woreno/mkultra-raspberry-pi-pico/mcu/docs/UI.png

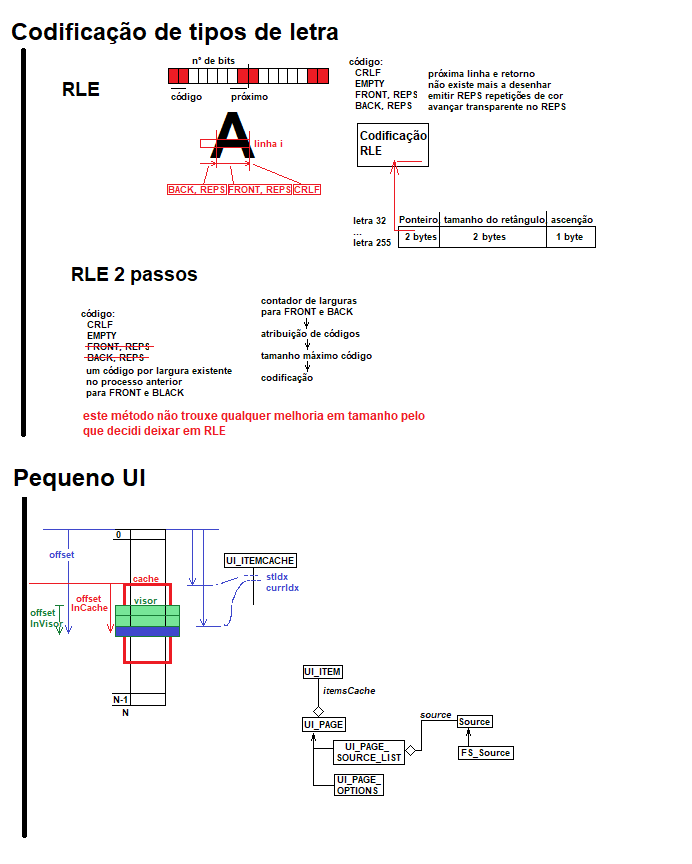
mcu/docs/UI.png
