woreno/mkultra-raspberry-pi-pico/Simple diagram.png

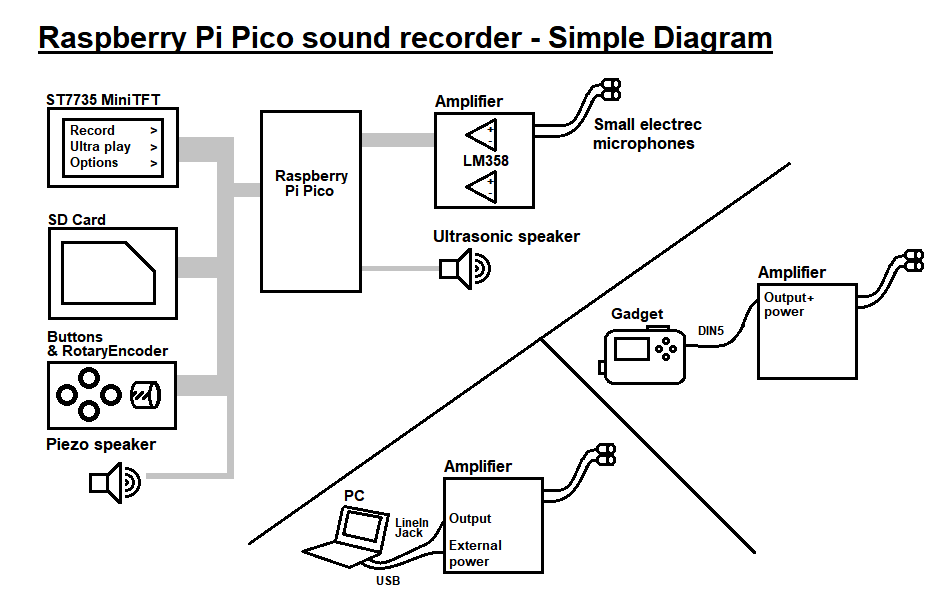
Simple diagram.png
