woreno/mkultra-raspberry-pi-pico/KICAD/microfones.kicad_pcb

## KiCad design KICAD/microfones.kicad_pcb (2026-11-10)

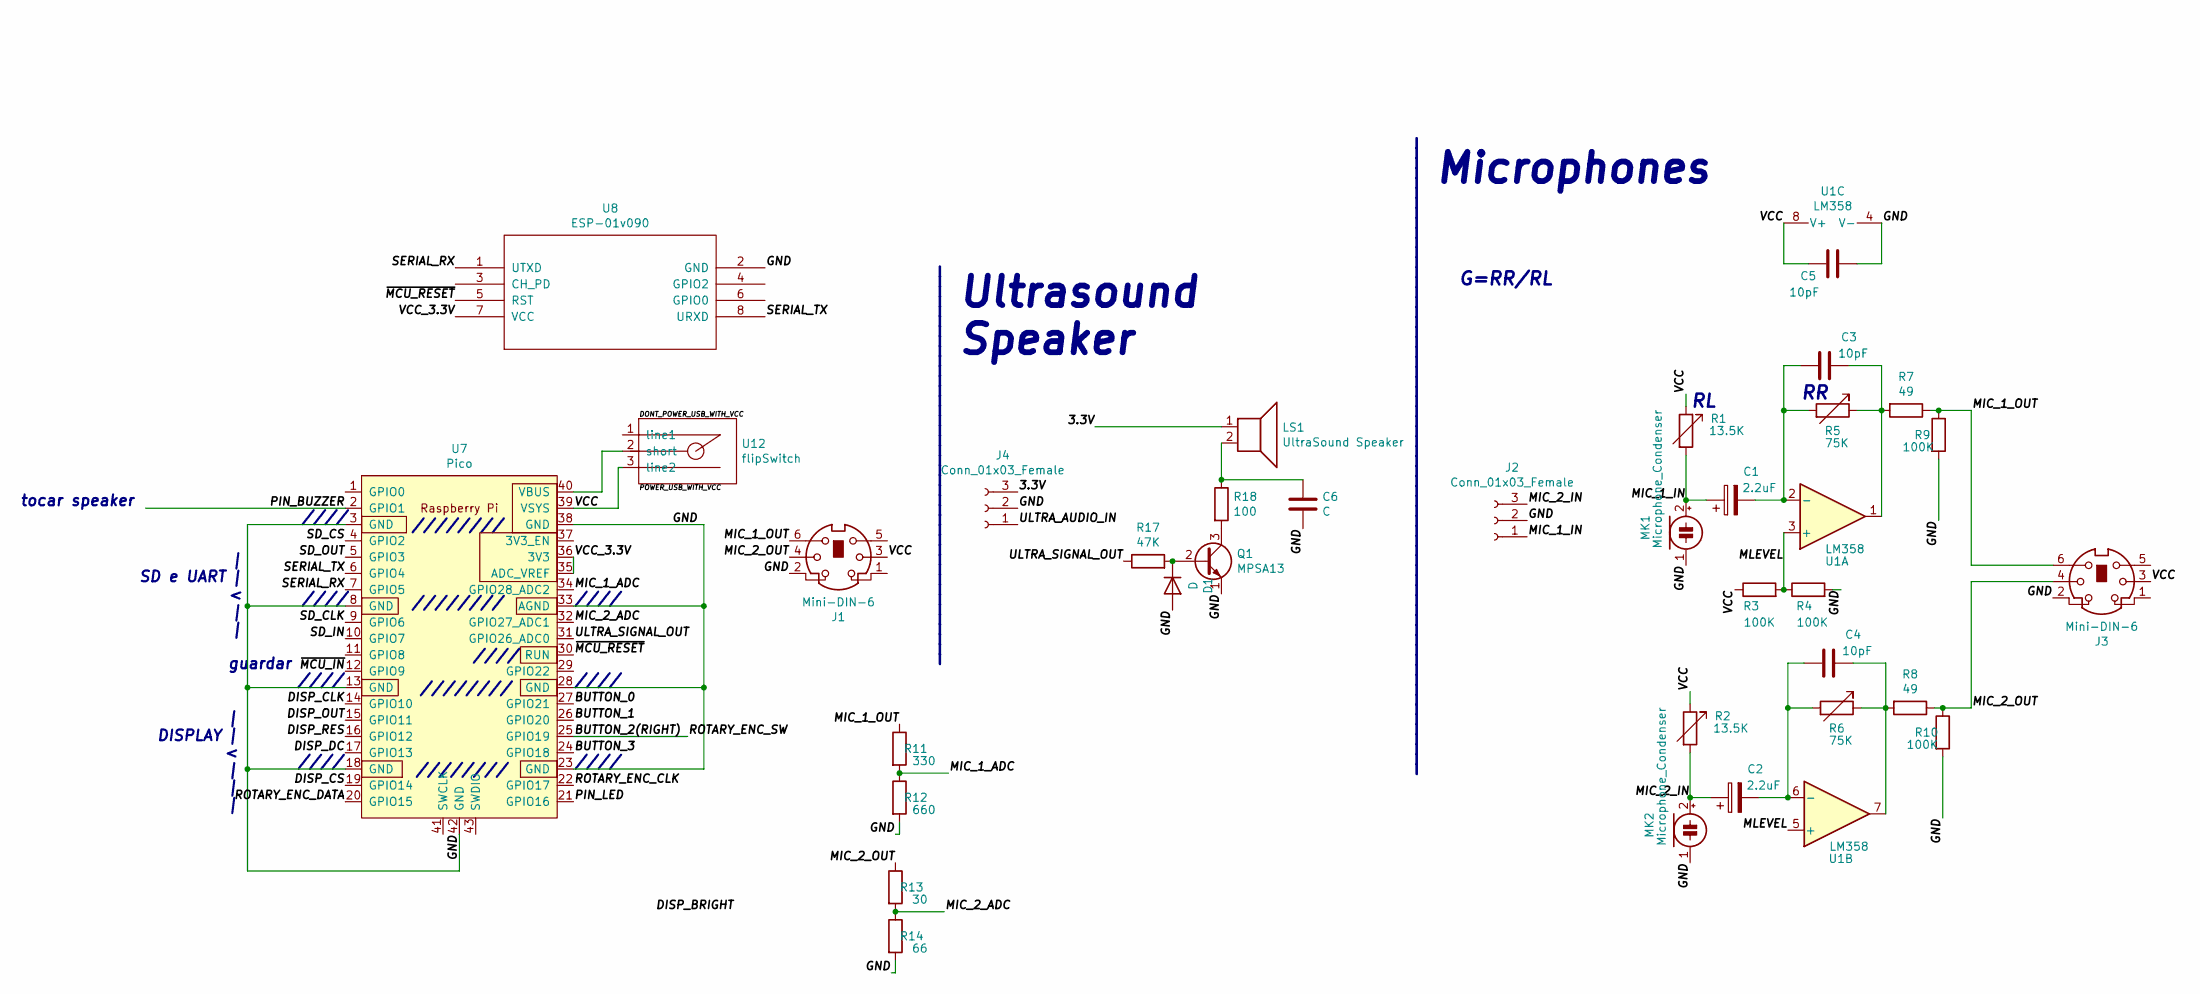
[picture p3: schematic microfones.sch]

Parts:
C1, C2: 2.2uF; standard_2pins
C3, C4, C5: 10pF; standard_2pins_half
C6: C; standard_2pins_half
D1: D; standard_2pins
J1, J3: Mini-DIN-6; minidin5
J2, J4: Conn_01x03_Female; PinHeader_1x03_P1.00mm_Horizontal
LS1: UltraSound Speaker; standard_2pins
MK1, MK2: Microphone_Condenser; standard_2pins
Q1: MPSA13; TO-92_Inline
R1, R2: 13.5K; standard_2pins
R3, R4, R9, R10: 100K; standard_2pins
R5, R6: 75K; standard_2pins
R7, R8: 49; standard_2pins
R11: 330; standard_2pins
R12: 660; standard_2pins
R13: 30; standard_2pins
R14: 66; standard_2pins
R17: 47K; standard_2pins
R18: 100; standard_2pins
U1: LM358; standard_DIP_8pins
U7: Pico; RPi_Pico_SMD_TH
U8: ESP-01v090; IDC-Header_2x04_P2.54mm_Horizontal
U12: flipSwitch; flipSwitch3

Connections:
/3.3V: J4.3, LS1.1
/BUTTON_0: U7.27 (GPIO21)
/BUTTON_1: U7.26 (GPIO20)
/BUTTON_2: U7.25 (GPIO19)
/BUTTON_3: U7.24 (GPIO18)
/DISP_CLK: U7.14 (GPIO10)
/DISP_CS: U7.19 (GPIO14)
/DISP_DC: U7.17 (GPIO13)
/DISP_OUT: U7.15 (GPIO11)
/DISP_RES: U7.16 (GPIO12)
/GND: C5.2, C6.2, D1.2 (A), J1.2, J2.2, J3.2, J4.2, MK1.1 (-), MK2.1 (-), Q1.1 (E), R4.2, R9.2, R10.2, R12.2, R14.2, U1.4 (V-), U7.3 (GND), U7.8 (GND), U7.13 (GND), U7.18 (GND), U7.23 (GND), U7.28 (GND), U7.33 (AGND), U7.38 (GND), U7.42 (GND), U8.2 (GND)
/MIC_1_ADC: R11.2, R12.1, U7.34 (GPIO28_ADC2)
/MIC_1_IN: C1.1, J2.1, MK1.2 (+), R1.2
/MIC_1_OUT: J1.6, J3.6, R7.1, R9.1, R11.1
/MIC_2_ADC: R13.2, R14.1, U7.32 (GPIO27_ADC1)
/MIC_2_IN: C2.1, J2.3, MK2.2 (+), R2.2
/MIC_2_OUT: J1.4, J3.4, R8.1, R10.1, R13.1
/MLEVEL: R3.2, R4.1, U1.3 (+), U1.5 (+)
/PIN_BUZZER: U7.2 (GPIO1)
/PIN_LED: U7.21 (GPIO16)
/SD_CLK: U7.9 (GPIO6)
/SD_CS: U7.4 (GPIO2)
/SD_IN: U7.10 (GPIO7)
/SD_OUT: U7.5 (GPIO3)
/SERIAL_RX: U7.7 (GPIO5), U8.1 (UTXD)
/SERIAL_TX: U7.6 (GPIO4), U8.8 (URXD)
/VCC: C5.1, J1.3, J3.3, R1.1, R2.1, R3.1, U1.8 (V+), U7.39 (VSYS), U12.3 (line2)
/VCC_3.3V: U7.35 (ADC_VREF), U7.36 (3V3), U8.7 (VCC)
/~MCU_IN: U7.12 (GPIO9)
/~MCU_RESET: U7.30 (RUN), U8.5 (RST)
unnamed: C1.2, C3.2, R5.2, U1.2 (-)
unnamed: C2.2, C4.2, R6.2, U1.6 (-)
unnamed: C3.1, R5.1, R7.2, U1.1
unnamed: C4.1, R6.1, R8.2, U1.7
unnamed: C6.1, LS1.2, R18.1
unnamed: D1.1 (K), Q1.2 (B), R17.2
unnamed: Q1.3 (C), R18.2
unnamed: U7.40 (VBUS), U12.2 (short)

Notes on the sheet:
| | < | |
SD e UART
| | < | | |
DISPLAY
////
////////
guardar
tocar speaker
Ultrasound Speaker
________________________________________
________________________________________________________________
Microphones
G=RR/RL

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
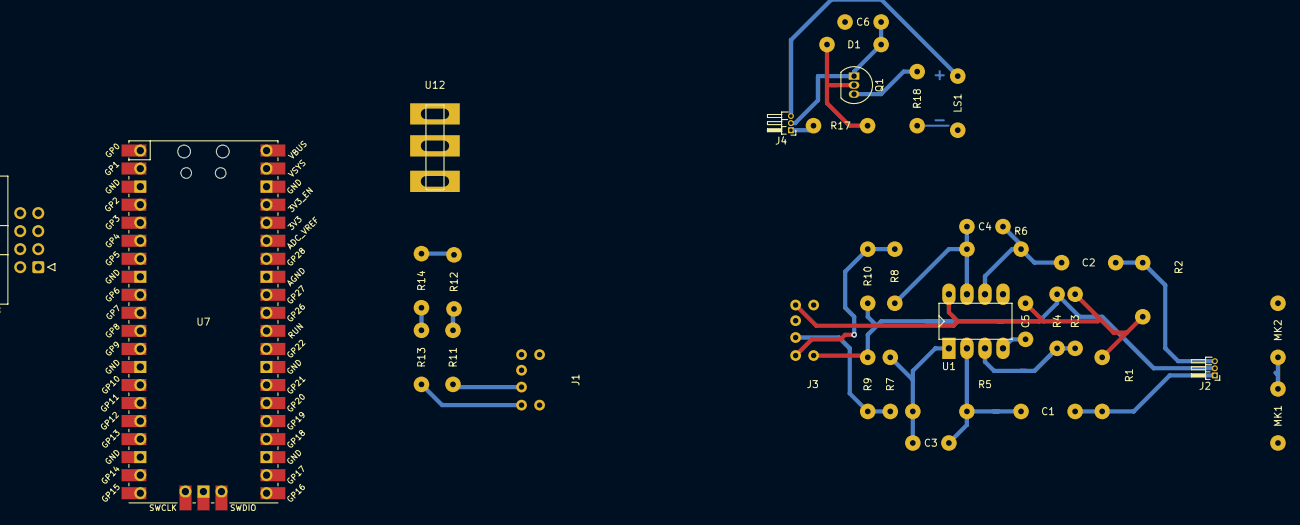
[picture p4: board microfones.kicad_pcb from above]

Board: 2 copper layers, 35 parts (0 on the bottom side), 23 nets.
