woreno/mkultra-raspberry-pi-pico/mcu/charmap.h

 VL_PACK_BEGIN 			   
 struct VL_PACK_MIDDLE FontInfo 			   
 {			   
  W16 ptrOffset;			   
  SW8 ascender;			   
  W8 width;			   
  SW8 height; 			   
 }; VL_PACK_END

 
#define fontEncodeBitmap		1 // pixel a pixel, com resolucao 1 ou 2 bpp
#define fontEncodeRLE			2 // codigos com as larguras e mudanca de linha
#define fontEncodeRLE_2PASS	3 // codigos apenas com para as larguras existentes
#define   fontEncodeSelected	2 // <--- codificacao deste desta fonte
#define fontBlockX				15 // em pixeis
#define fontBlockY				19 // em pixeis
#define fontDefaultSpace       -1 // em pixeis
#define fontMonospaced		    50 // se posto em space_, usa a mesma width
#define fontCodeIsEmpty  0
#define fontCodeIsCRLF   1
#define fontCodeIsFront  2
#define fontCodeIsBack   3
#define fontRLEDataBits  4
#define fontRLECodeBits  2

const W8 fontMap[] VL_STORE_FLASH_GROUP("FONTMAP") VL_ALIGN(4) = {
 0x52,  0x52,  0x52,  0x52,  0x52,  0x52,  0x52,  0x52,  0x52,  0x52,  0xD5,  0xA1,  0x24,  0x05,  0x00,  0x00,  // char ASCII '!' (0x21)
 0x56,  0x56,  0x56,  0x56,  0x56,  0x00,  0x00,  0x00,  // char ASCII '"' (0x22)
 0x93,  0xD6,  0x64,  0x35,  0x59,  0x4D,  0x56,  0x87,  0xD9,  0x61,  0xF6,  0x58,  0x3D,  0x56,  0x8F,  0x95,  0x9A,  0xDA,  0xA2,  0xB5,  0x58,  0x2D,  0x56,  0x8B,  0x15,  0x00,  0x00,  0x00,  // char ASCII '#' (0x23)
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
 0xCC, 0x02, 0x0F,  0x12, 0x13,  
 0xFC, 0x02, 0x0F,  0x0D, 0x13,  
 0x24, 0x03, 0x0F,  0x0D, 0x13,  
 0x44, 0x03, 0x0F,  0x0D, 0x13,  
 0x64, 0x03, 0x0F,  0x0D, 0x13,  
 0x84, 0x03, 0x0F,  0x0C, 0x13,  
 0x94, 0x03, 0x0F,  0x0C, 0x13,  
 0xA4, 0x03, 0x0F,  0x0D, 0x13,  
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
}; // bytes: 672
