woreno/mkultra-raspberry-pi-pico/app_strings.h

const SW8 ui_strs_mkultra[]			VL_STORE_FLASH_GROUP("STRS") = "MKUltra";
const SW8 ui_strs_sep[]				VL_STORE_FLASH_GROUP("STRS") = " - ";
const SW8 ui_strs_init[]			VL_STORE_FLASH_GROUP("STRS") = "Init";
const SW8 ui_strs_esp[]				VL_STORE_FLASH_GROUP("STRS") = "ESP";
const SW8 ui_strs_wifi[]			VL_STORE_FLASH_GROUP("STRS") = "WIFI";
const SW8 ui_strs_server[]			VL_STORE_FLASH_GROUP("STRS") = "Server";
const SW8 ui_strs_sd[]				VL_STORE_FLASH_GROUP("STRS") = "SD Card";
const SW8 ui_strs_formatDisk[]		VL_STORE_FLASH_GROUP("STRS") = "Format Disk";
const SW8 ui_strs_fs[]				VL_STORE_FLASH_GROUP("STRS") = "FS";
const SW8 ui_strs_alloc[]			VL_STORE_FLASH_GROUP("STRS") = "Alloc!";
const SW8 ui_strs_fail[]			VL_STORE_FLASH_GROUP("STRS") = "Failed";
const SW8 ui_strs_invalid[]			VL_STORE_FLASH_GROUP("STRS") = "Invalid";
const SW8 ui_strs_cmd[]				VL_STORE_FLASH_GROUP("STRS") = "cmd";
const SW8 ui_strs_mbr_volumes[]		VL_STORE_FLASH_GROUP("STRS") = "MBR";
const SW8 ui_strs_vol_root[]		VL_STORE_FLASH_GROUP("STRS") = "Root";
const SW8 ui_strs_start[]			VL_STORE_FLASH_GROUP("STRS") = "Start";
const SW8 ui_strs_menu[]			VL_STORE_FLASH_GROUP("STRS") = "Menu";
const SW8 ui_strs_stereo[]			VL_STORE_FLASH_GROUP("STRS") = "Stereo";
const SW8 ui_strs_off[]				VL_STORE_FLASH_GROUP("STRS") = "OFF";
const SW8 ui_strs_on[]				VL_STORE_FLASH_GROUP("STRS") = "ON";
const SW8 ui_strs_writingnotes[]	VL_STORE_FLASH_GROUP("STRS") = "Writing Notes";
const SW8 ui_strs_ready[]			VL_STORE_FLASH_GROUP("STRS") = "Ready";
const SW8 ui_strs_null[]			VL_STORE_FLASH_GROUP("STRS") = "NULL";
const SW8 ui_strs_rate[]			VL_STORE_FLASH_GROUP("STRS") = "Rate";
const SW8 ui_strs_bits[]			VL_STORE_FLASH_GROUP("STRS") = "Bits";
const SW8 ui_strs_done[]			VL_STORE_FLASH_GROUP("STRS") = "Done";
const SW8 ui_strs_stopping[]		VL_STORE_FLASH_GROUP("STRS") = "Stopping...";
const SW8 ui_strs_reconnect[]		VL_STORE_FLASH_GROUP("STRS") = "Reconnect";
const SW8 ui_strs_notconnected[]	VL_STORE_FLASH_GROUP("STRS") = "Not connected";
const SW8 ui_strs_txrecords[]		VL_STORE_FLASH_GROUP("STRS") = "Send Records";
const SW8 ui_strs_notmounted[]		VL_STORE_FLASH_GROUP("STRS") = "Not mounted";
const SW8 ui_strs_sending[]			VL_STORE_FLASH_GROUP("STRS") = "Sending";
const SW8 ui_strs_debugnotes[]		VL_STORE_FLASH_GROUP("STRS") = "Note Debug";
const SW8 ui_strs_wait[]			VL_STORE_FLASH_GROUP("STRS") = "Wait";  
const SW8 ui_strs_hz[]				VL_STORE_FLASH_GROUP("STRS") = "Hz";
const SW8 ui_strs_khz[]				VL_STORE_FLASH_GROUP("STRS") = "KHz";
const SW8 ui_strs_record[]			VL_STORE_FLASH_GROUP("STRS") = "Record";
const SW8 ui_strs_recording[]		VL_STORE_FLASH_GROUP("STRS") = "Recording";
const SW8 ui_strs_recordmics[]		VL_STORE_FLASH_GROUP("STRS") = "Record Mics";
const SW8 ui_strs_testrecord[]		VL_STORE_FLASH_GROUP("STRS") = "Test Record";
const SW8 ui_strs_miclevels[]		VL_STORE_FLASH_GROUP("STRS") = "Mic Levels";
const SW8 ui_strs_playultrawave[]	VL_STORE_FLASH_GROUP("STRS") = "UltraWave";
const SW8 ui_strs_playultrasnd[]	VL_STORE_FLASH_GROUP("STRS") = "Play UltraFile";
const SW8 ui_strs_freq[]			VL_STORE_FLASH_GROUP("STRS") = "Freq";
const SW8 ui_strs_apptitle[]		VL_STORE_FLASH_GROUP("STRS") = "MKUltra";

const W16 sampleRatesArr[]  = { 8000, 11500, 22050, 44100 };
const W16 sampleBitsArr[]   = { 8, 16 };


#define AUDIO_SAMPLE_RATE_8000   0
#define AUDIO_SAMPLE_RATE_11500  1
#define AUDIO_SAMPLE_RATE_22050  2
#define AUDIO_SAMPLE_RATE_44100  3

#define AUDIO_SAMPLE_BITS_8      0
#define AUDIO_SAMPLE_BITS_16     0
