woreno/mkultra-raspberry-pi-pico/uiIconsData.hpp

//Bitmap w:64 h:22 bpp:4 | bytesPerRow:32 (padded) bytesPad:0

#define iconData_W 64
#define iconData_H 22
#define iconData_COLS_BYTESZ 32
#define iconData_REPS  1
#define iconData_ALIGN  4 // bytes
#define iconData_EXTRA_COLS_BYTES  0 // bytes
#define iconData_EXTRA_ROWS  0 // rows
#define iconData_COLS_TOTAL_BYTESZ  32 // bytes
#define iconData_ROWS_TOTAL 22 // bytes
const W8 iconData[] VL_STORE_FLASH_GROUP("ICONDATA") VL_ALIGN(4) =  {
//ROW 0 / 21 

 0xCC, 0xCC, 0xCC, 0xCC, 0xCC, 0xCC, 0xCC, 0xCC, 0xCC, 0xCC, 0xCC, 0x7C, 0x77, 0xC7, 0xCC, 0xCC, 
 0xCC, 0xCC, 0xCC, 0xCC, 0xCC, 0xCC, 0xCC, 0xCC, 0xCC, 0xCC, 0xCC, 0xCC, 0xCC, 0xCC, 0xCC, 0xCC, 
//ROW 1 / 21 

 0xCC, 0xCC, 0xCC, 0xCC, 0xCC, 0xCC, 0xCC, 0xCC, 0xCC, 0xCC, 0x0C, 0xF7, 0xFF, 0x7F, 0xC0, 0xCC, 
 0xCC, 0xCC, 0xCC, 0xCC, 0xCC, 0xCC, 0xCC, 0xCC, 0xCC, 0xCC, 0xCC, 0xCC, 0xCC, 0xCC, 0xCC, 0xCC, 
//ROW 2 / 21 

 0xCC, 0xCC, 0xCC, 0x7C, 0x00, 0x00, 0x70, 0xCC, 0xCC, 0xCC, 0x70, 0xBF, 0xBB, 0xBB, 0x07, 0xCC, 
 0xCC, 0x0C, 0x00, 0x00, 0x00, 0x00, 0x00, 0xC0, 0xCC, 0xCC, 0xCC, 0xCC, 0xCC, 0xCC, 0xCC, 0xCC, 
//ROW 3 / 21 

 0xCC, 0xCC, 0xCC, 0x0C, 0xFF, 0xFF, 0x0F, 0xCC, 0xCC, 0xCC, 0xF0, 0x7B, 0x77, 0xB7, 0x08, 0xCC, 
 0xCC, 0x70, 0xFF, 0xFF, 0xFF, 0xFF, 0xFF, 0x07, 0xCC, 0xCC, 0xCC, 0xCC, 0xCC, 0xCC, 0xCC, 0xCC, 
//ROW 4 / 21 

 0xCC, 0x0C, 0x00, 0xF0, 0xBB, 0xBB, 0x0B, 0xCC, 0xCC, 0xCC, 0xF0, 0x08, 0x00, 0xB7, 0x0B, 0xCC, 
 0x0C, 0xF7, 0xFF, 0xFF, 0xFF, 0xFF, 0xFF, 0x07, 0xCC, 0xCC, 0x00, 0xCC, 0xCC, 0x00, 0xCC, 0xCC, 
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
//ROW 21 / 21 

 0xF0, 0xFF, 0xFF, 0xFF, 0xFF, 0xFF, 0xFF, 0xFF, 0xF0, 0xFF, 0xFF, 0xFF, 0xFF, 0xFF, 0xFF, 0xFF, 
 0xF0, 0xFF, 0xFF, 0xFF, 0xFF, 0xFF, 0xFF, 0xFF, 0xF0, 0xFF, 0xFF, 0xFF, 0xFF, 0xFF, 0xFF, 0xFF, 
};
